niklauslee/kameleon-board/kameleon-core/kameleon-core-schematic_v1p0p0.pdf

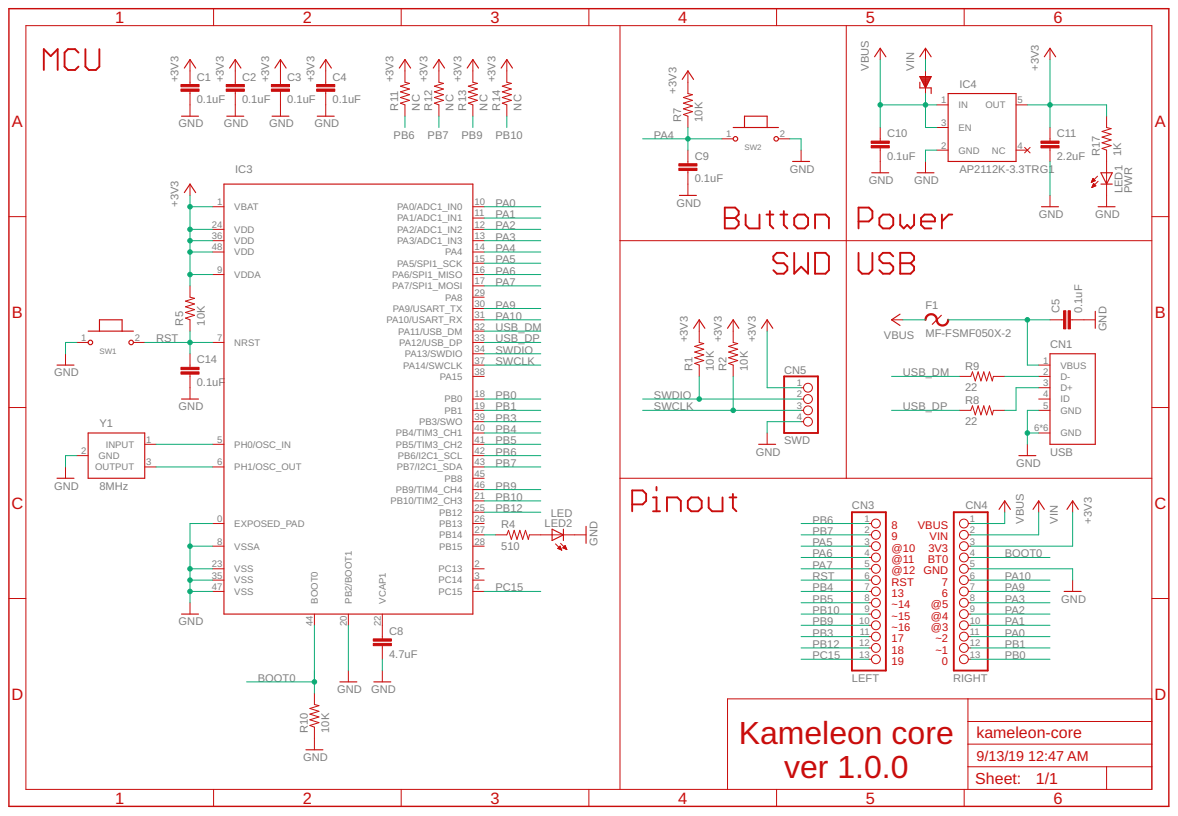
[picture p1: page 1]

Kameleon core
