niklauslee/kameleon-board/kameleon-core/kameleon-core.brd

## EAGLE design kameleon-core/kameleon-core.brd (2019-11-07)

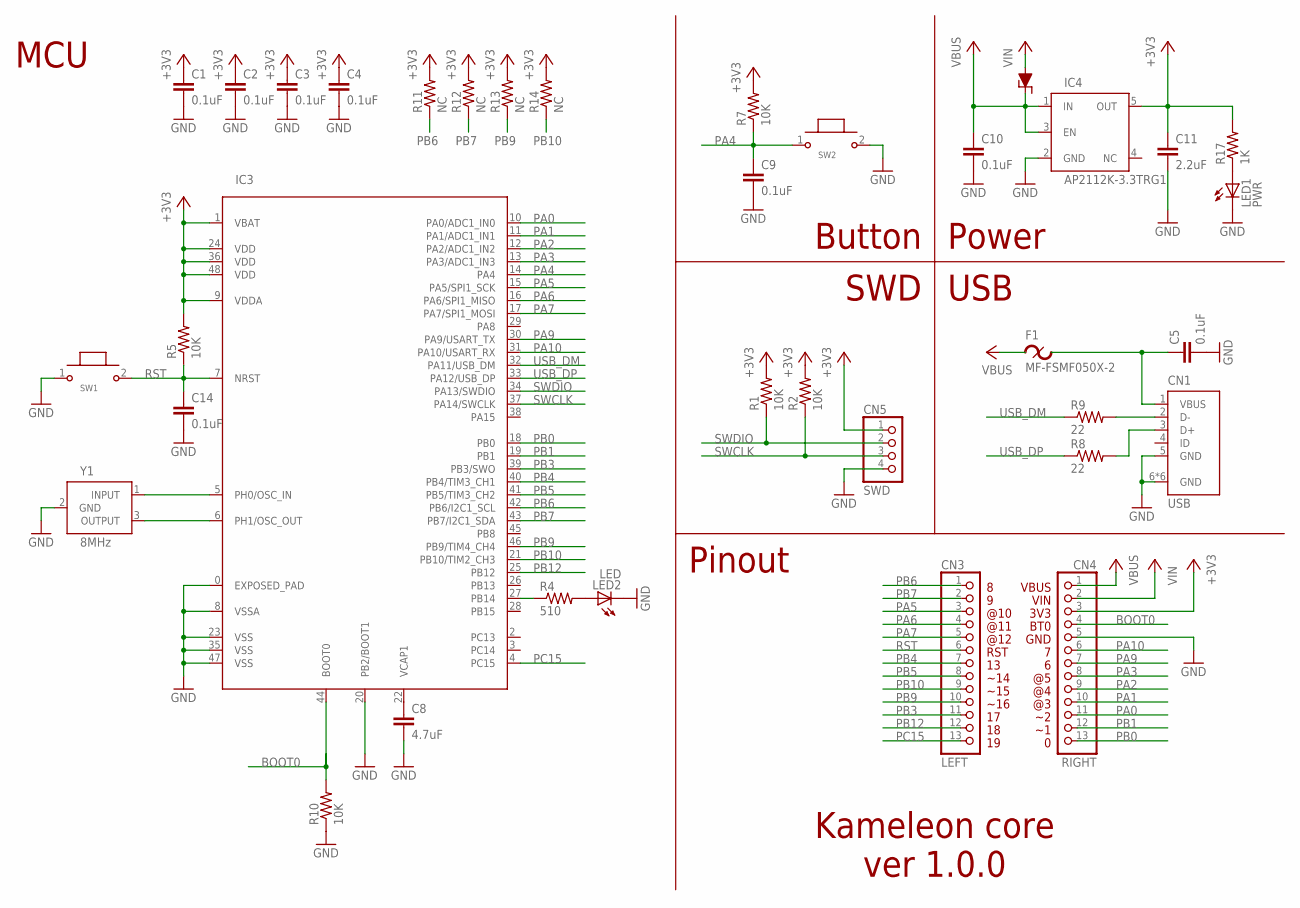
[picture p2: schematic kameleon-core.sch]

Parts:
C1, C2, C3, C4, C5, C9, C10, C14: 0.1uF; 1608
C8: 4.7uF; 2012
C11: 2.2uF; 2012
CN1: USB; 1050170001
CN3: LEFT; 1X13
CN4: RIGHT; 1X13
CN5: SWD; 1X04
D1: MBR120VLSF; SOD-123FL
F1: MF-FSMF050X-2; 1608
IC3: STM32F411CE/UFQFPN48; UFQFPN48
IC4: AP2112K-3.3TRG1; SOT25
LED1: PWR; D1608
LED2: LED; D1608
R1, R2, R5, R7, R10: 10K; 1608
R4: 510; 1608
R8, R9: 22; 1608
R11, R12, R13, R14: NC; 1608
R17: 1K; 1608
SW1: NRST; NW3-A03-05
SW2: BTN; NW3-A03-05
Y1: 8MHz; R0

Connections:
+3V3: C1.1, C2.1, C3.1, C4.1, C11.1, CN4.3, CN5.1, IC3.1 (VBAT), IC3.9 (VDDA), IC3.24 (VDD), IC3.36 (VDD), IC3.48 (VDD), IC4.5 (OUT), R1.2, R2.2, R5.2, R7.2, R11.2, R12.2, R13.2, R14.2, R17.2
BOOT0: CN4.4, IC3.44 (BOOT0), R10.2
GND: C1.2, C2.2, C3.2, C4.2, C5.2, C8.2, C9.2, C10.2, C11.2, C14.2, CN1.5 (GND), CN1.6 (GND), CN1.7 (GND), CN1.8 (GND), CN1.9 (GND), CN1.10 (GND), CN1.11 (GND), CN4.5, CN5.4, IC3.0 (EXPOSED_PAD), IC3.8 (VSSA), IC3.20 (PB2/BOOT1), IC3.23 (VSS), IC3.35 (VSS), IC3.47 (VSS), IC4.2 (GND), LED1.2 (C), LED2.2 (C), R10.1, SW1.1, SW2.2, Y1.2 (GND)
unnamed: C8.1, IC3.22 (VCAP1)
unnamed: IC3.5 (PH0/OSC_IN), Y1.1 (INPUT)
unnamed: IC3.6 (PH1/OSC_OUT), Y1.3 (OUTPUT)
unnamed: CN1.2 (D-), R9.2
unnamed: IC3.27 (PB14), R4.1
unnamed: LED2.1 (A), R4.2
unnamed: CN1.3 (D+), R8.2
unnamed: C5.1, CN1.1 (VBUS), F1.2
unnamed: LED1.1 (A), R17.1
PA0: CN4.11, IC3.10 (PA0/ADC1_IN0)
PA1: CN4.10, IC3.11 (PA1/ADC1_IN1)
PA2: CN4.9, IC3.12 (PA2/ADC1_IN2)
PA3: CN4.8, IC3.13 (PA3/ADC1_IN3)
PA4: C9.1, IC3.14 (PA4), R7.1, SW2.1
PA5: CN3.3, IC3.15 (PA5/SPI1_SCK)
PA6: CN3.4, IC3.16 (PA6/SPI1_MISO)
PA7: CN3.5, IC3.17 (PA7/SPI1_MOSI)
PA9: CN4.7, IC3.30 (PA9/USART_TX)
PA10: CN4.6, IC3.31 (PA10/USART_RX)
PB0: CN4.13, IC3.18 (PB0)
PB1: CN4.12, IC3.19 (PB1)
PB3: CN3.11, IC3.39 (PB3/SWO)
PB4: CN3.7, IC3.40 (PB4/TIM3_CH1)
PB5: CN3.8, IC3.41 (PB5/TIM3_CH2)
PB6: CN3.1, IC3.42 (PB6/I2C1_SCL), R11.1
PB7: CN3.2, IC3.43 (PB7/I2C1_SDA), R12.1
PB9: CN3.10, IC3.46 (PB9/TIM4_CH4), R13.1
PB10: CN3.9, IC3.21 (PB10/TIM2_CH3), R14.1
PB12: CN3.12, IC3.25 (PB12)
PC15: CN3.13, IC3.4 (PC15)
RST: C14.1, CN3.6, IC3.7 (NRST), R5.1, SW1.2
SWCLK: CN5.3, IC3.37 (PA14/SWCLK), R2.1
SWDIO: CN5.2, IC3.34 (PA13/SWDIO), R1.1
USB_DM: IC3.32 (PA11/USB_DM), R9.1
USB_DP: IC3.33 (PA12/USB_DP), R8.1
VBUS: C10.1, CN4.1, D1.2, F1.1, IC4.1 (IN), IC4.3 (EN)
VIN: CN4.2, D1.1

Notes on the sheet:
Power
Button
SWD
USB
MCU
Pinout
VBUS VIN 3V3 BT0 GND 7 6 @5 @4 @3 ~2 ~1 0
8 9 @10 @11 @12 RST 13 ~14 ~15 ~16 17 18 19
Kameleon core ver 1.0.0

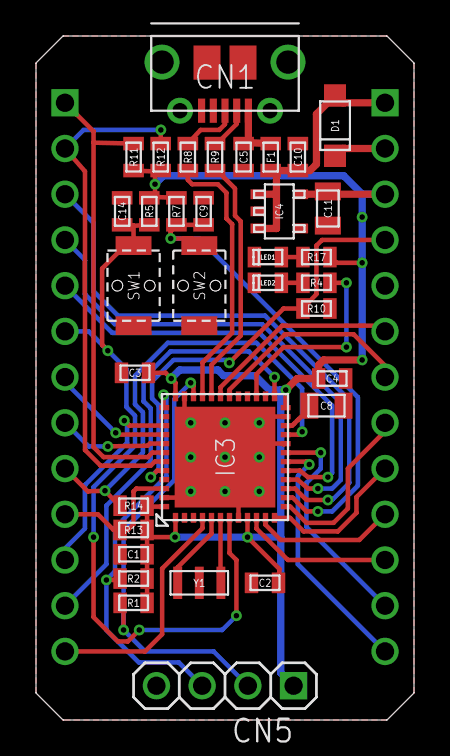
[picture p3: board kameleon-core.brd from above]

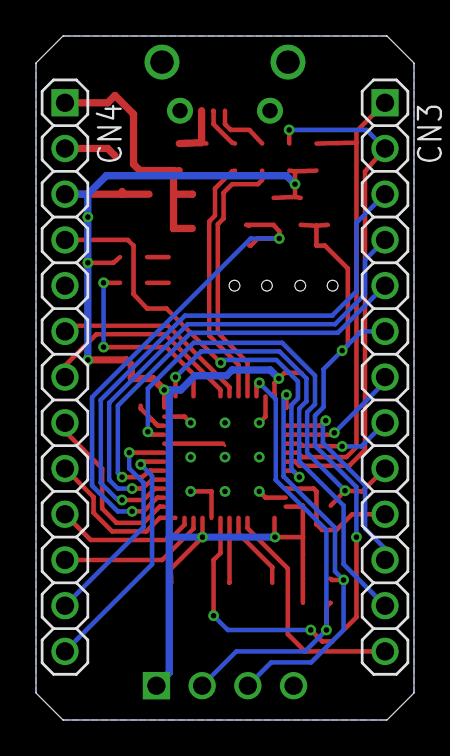
[picture p4: board kameleon-core.brd from below]

Board: 2 copper layers, 21.0 x 38.0 mm, 37 parts (3 on the bottom side), 40 nets.

Other parts of the board:
U$1: LOGO_VECTOR
