niklauslee/kameleon-board/(commit log)

2018-10-10 Kameleon Core board
    [kameleon-core.brd, kameleon-core.sch]
2019-09-07 Eagle cad update - New format of the latest Eable cad
    [kameleon-core.brd, kameleon-core.sch]
2019-09-07 Change R10 value to 10K
    [kameleon-core.brd, kameleon-core.sch]
2019-09-07 Remove R3 and R6 because it's not needed
    [kameleon-core.brd, kameleon-core.sch]
2019-09-08 Change CN3 and CN4 from Top to Bottom. - Resolve the issue #3
    [kameleon-core.brd]
2019-09-10 I2C pull-ups are changed from 10K to NC
    [kameleon-core.brd, kameleon-core.sch]
2019-09-12 Adding schematic of the Kameleon-core V1.0 board
2019-09-13 Board name changed in English Version is changed to 1.0.0
    [kameleon-core.sch]
2019-11-07 Fix the unexpected change on the 3v3 wire on the bottom. - Resolve the issue #7
    [kameleon-core.brd]
